darconeous/soil-moisture-sensor/protocol.txt

# Soil Moisture Sensor Protocol Documentation #

NOTE: THIS IS ALL CURRENTLY IN FLUX. THIS DOCUMENTATION MAY NOT REFLECT THE
ACTUAL PROTOCOL IMPLEMENTED IN THE SOURCE CODE. THIS WILL BE FIXED BEFORE THE
OFFICIAL RELEASE.

# Physical-layer Bus Protocol #

The firmware on this sensor can be compiled to use any number of physical
protocols for communication. These protocols define how individual bits are
sent and received from the bus. These include:

 * 1-Wire® Compatible: DO NOT USE. SEE PATENT NOTICE BELOW.
 * Fox-Bus™: Similar to 1-Wire®, but not patented and with better
   noise resistance. <http://fox-bus.org/>
 * 2-Wire: Uses two wires, SCL(clock) and SDA(data).

The recommended and default physical bus protocol is Fox-Bus™.

## IMPORTANT PATENT NOTICE ##

THE PHYSICAL LAYER OF THE 1-WIRE® PROTOCOL IS PATENTED:

	* USPAT#6,108,751
	* USPAT#5,974,504
	* USPAT#5,864,872
	* USPAT#5,587,955
	* USPAT#5,517,015

MAXIM-IC, THE OWNER OF THIS PATENT, HAS EXPLICITLY STATED THAT THEY ARE
UNABLE/UNWILLING TO GRANT ANY LICENSE FOR THE USE OF THE 1-WIRE PROTOCOL
ON NON-MAXIM SLAVE DEVICES. AS SUCH, IF YOU CHOOSE TO USE THE 1-WIRE PHYSICAL
PROTOCOL FOR THIS PROJECT, IT COULD EXPOSE YOU TO SUBSTANTIAL AND DEVISTATING
CIVIL LIABILITY---EVEN FOR PERSONAL USE.

USE FOX-BUS™ INSTEAD. YOU HAVE BEEN WARNED.

(THE 1-WIRE PROTOCOL WILL BE UNENCOMBERED BY PATENTS IN THE UNITED STATES NO
SOONER THAN 2013-05-14)

### 1-Wire Link-layer ###

The earliest published reference to the link-layer of the 1-Wire protocol
that I have found so far is in USPAT#5,517,015. In that patent, the link-layer
protocol is not mentioned in the claims, even though it is described in the
body of the patent. If it isn't claimed, it isn't covered. USPAT#5,809,518 comes
close, but its claims are very narrow in scope. Even if those claims could be
made to apply to this application, the patent was filed over one year after the
filing date for USPAT#5,517,015---which originally published (but did not claim)
the link-layer bus protocol for 1-Wire. From what I understand, under US patent
law, an entity has one year after an invention is first published to file for a
patent. That has clearly not happened in the case for the 1-Wire link-level
protocol.

Baring any discovery which would indicate otherwise I am assuming that the
link-layer of the 1-Wire protocol is, for this application, not patent
encumbered.

# Link-layer Bus Protocol #

Since link-layer of the 1-Wire® protocol appears to not be patented,
the link-layer bus protocol used for this project is similar to that of
1-Wire®. See any documentation of the 1-Wire® protocol for more details.

Alternative link-layer bus protocols (Like I²C) may be implemented in the future
if the need arrises.

## ROM Commands ##

This device supports the following ROM funcitons:

 * `0x33` READROM
 * `0x55` MATCHROM
 * `0xCC` SKIPROM
 * `0xF0` SEARCH
 * `0xEC` ALARMSEARCH

Overdrive commands are not supported.

## Function Commands ##

This device supports the following funciton commands:

 * `0xAA` READMEM
 * `0x55` WRITEMEM
 * `0x48` COMMITMEM
 * `0xB8` RECALLMEM
 * `0x3C` CONVERT
 * `0x44` CONVERT_T
 * `0xBE` RD_SCRATCH (Only when built with DS18B20 compatibility mode)

### READMEM and WRITEMEM ###

READMEM and WRITEMEM work similar to how they work on other 1-Wire® or
iButton® devices: each takes a two-byte start address and then either
reads out or reads in bytes to be read or written respectively. At each
eight-byte page boundary, a 16-bit CRC is returned from the device.

See the datasheet for the DS2450 for more information on how to use READMEM
and WRITEMEM. See the "Memory Map" section below for an explanation of the
data structures.

### COMMITMEM and RECALLMEM ###

The values contained in the later two pages of memory (0x08-0x17) are loaded
from EEPROM when the device is first powered up. If you modify values at these
locations using the WRITEMEM command, you will lose your changes the next time
the device power-cycles unless you issue a COMMITMEM command. The COMMITMEM
command will save the contents of the later two pages to EEPROM so that the
values will persist across power cycles.

The RECALLMEM command will cause the device to revert any changes made to the
last two pages by updating them with the current values stored in EEPROM,
similar to what happens when the device is first powered up.

### CONVERT and CONVERT_T ###

The CONVERT and CONVERT_T commands are used to initiate the sensor's sampling
process. Upon completion, the value of the sensor's readings can be retrieved
from the first page (0x00-0x07) of memory using the READMEMORY command.

There is only one difference between the two commands: CONVERT_T begins the
conversion process immediately after the last bit of the command is sent,
whereas the CONVERT command expects two bytes (the values of which are ignored)
before the conversion process begins.

The device will be busy while the conversion is taking place---issuing a
1-wire reset on the bus will interrupt the conversion process. The status
of the conversion may be polled by sending read time slots. While the device
is busy converting, a read time slot will return '0'. When it is finished,
it will return '1'.

The CONVERT command is compatible with DS2450-type parts, and the CONVERT_T is
compatible with DS18B20-type parts.

### RD_SCRATCH ###

This command allows the device to behave like a DS18B20 temperature sensor.
It is only available on hardware that has built-in temperature sensors and when
the firmware has been built with DS18B20 emulation enabled.

The only fields with valid values are the temperature field and the CRC field.
All other bytes should be ignored. The WR_SCRATCH command is not supported.

See the DS18B20 datasheet for more information.

## Memory Map ##

Below is the memory map of the device, accessable via the READMEM and WRITEMEM
commands.

### Page 0 - Sensor Values ###

 * `0x00` MOISTURE_L
 * `0x01` MOISTURE_H
 * `0x02` RAW_L
 * `0x03` RAW_H
 * `0x04` TEMPERATURE_L
 * `0x05` TEMPERATURE_H
 * `0x06` VOLTAGE_L
 * `0x07` VOLTAGE_H

MOISTURE_L and MOISTURE_H are the respective low and high bytes of the moisture
value. This value is calculated directly from the value of the RAW field and
the calibration data from page 2. The value ranges from 0x0000 (Most dry) to
0xFFFF (Most wet).

RAW_L and RAW_H are the respective low and high bytes of the raw capacitance
reading of the soil.

TEMPERATURE_L and TEMPERATURE_H are the respective low and high bytes of the
measured temperature. The value of this field is encoded in a format compatible
with the DS18B20 temperature reading. See the DS18B20 datasheet for more
details.

VOLTAGE_L and VOLTAGE_H are the respective low and high bytes of the
measured voltage. This value may be converted to the actual voltage using the
following formula:

    VCC = 1024.0*1.1/(VOLTAGE_L+(VOLTAGE_H<<8))

### Page 1 - Device Configuration and Status ###

 * `0x08` ALARM_LOW
 * `0x09` ALARM_HIGH
 * `0x0A` CFG_FLAGS
 * `0x0B` *Reserved*
 * `0x0C` *Reserved*
 * `0x0D` *Reserved*
 * `0x0E` *Reserved*
 * `0x0F` Firmware Revision

### Page 2 - Device Calibration ###

 * `0x10` CALIB_RAW_RANGE (Unsigned)
 * `0x11` CALIB_RAW_OFFSET (Unsigned)
 * `0x12` CALIB_FLAGS
 * `0x13` CALIB_TEMPERATURE_OFFSET (Signed)
 * `0x14` *Reserved*
 * `0x15` *Reserved*
 * `0x16` *Reserved*
 * `0x17` *Reserved*

See notes.txt for more information on calibration values.

## References ##

 * [1-Wire® Wikipedia Page](http://en.wikipedia.org/wiki/1-Wire)
 * [1-Wire®/iButton® Standard](http://www.maxim-ic.com/products/ibutton/ibuttons/standard.pdf)
 * [DS18B20 Datasheet](http://datasheets.maxim-ic.com/en/ds/DS18B20.pdf)
 * [DS2450 Datasheet](http://datasheets.maxim-ic.com/en/ds/DS2450.pdf)
 * [USPAT#6,108,751](http://patimg1.uspto.gov/.piw?Docid=06108751&idkey=NONE)
 * [Fox-Bus™](http://fox-bus.org/)
