darconeous/soil-moisture-sensor/(commit log)

2011-01-10 initial version
    [soil-moisture-sensor.brd, soil-moisture-sensor.sch]
2011-06-19 Source code cleanup for new one-zone sensor.
    [soil-moisture-sensor.brd, soil-moisture-sensor.sch]
2011-06-19 Rename soil-moisture-sensor.c to moist.c. Added main.c and moist.h.
2011-06-21 Initial work on wire protocol for reading soil moisture. Untested.
    This is me wrapping up several commits from last weekend.
2011-06-23 First working version.
    I can now enumerate the sensor as a 1-wire device and read
    out the soil moisture. Works with several 1-wire devices
    on the same bus. Still need to work out the exact protocol,
    but so far so good.
    Also adjusted the PCB design to take into account some
    lessons learned. Turns out just having one big sensor
    plane without a ground plane wasn't such a good idea after
    all.
    [soil-moisture-sensor.brd, soil-moisture-sensor.sch]
2011-06-25 Updated hardware design again.
    [soil-moisture-sensor.brd, soil-moisture-sensor.sch]
2011-06-28 Now using surface mount parts and an edge connector.
    [soil-moisture-sensor.brd, soil-moisture-sensor.sch]
2011-06-28 Added Gerber files.
2011-06-29 Updates from last night. Added calibration code. Various other changes.
    [soil-moisture-sensor.brd, soil-moisture-sensor.sch]
2011-06-30 Switched over to the ATTiny25.
2011-07-12 Lots of updates leading up to v1.0 release.
    This is the cumulation of many commits I've made to my own sandbox,
    and I think it's about time I push these to the main branch.
    [soil-moisture-sensor.brd, soil-moisture-sensor.sch]
2011-07-23 Remove most of the vias, and moved the rest to the top of the sensor.
    [soil-moisture-sensor.brd]
2011-08-07 Miscellaneous updates and tweaks as I build out my set of sensors.
2011-08-10 Added error and alarm status flags. Added more build notes.
    [main.c]
2011-08-16 Lots of changes for migrating from 1-Wire® over to Fox-Bus™.
    These changes are not complete, but in light of some recent
    developments I felt it was necessary to update the documentation
    of this project as soon as possible.
    It turns out that MAXIM is unable or unwilling to offer any
    license for the 1-Wire® slave protocol on a non-MAXIM IC.
    As a result of this revelation, a suitable alternative
    to the 1-Wire protocol must be found and used instead.
    For now, I have settled on Fox-Bus™, which has been developed
    by Chris Fox. This protocol is a free single-wire alternative
    to 1-Wire, and Chris is generously allowing this project
    to take advantage of his research to use his protocol.
    Chri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
2012-06-18 Starting work on a new design with a different mechanism of measurement.
    [soil-moisture-sensor.brd, soil-moisture-sensor.sch]
